mayoogh-flexli/Meesho-Put-To-Light/PTL-RAIL/PTL-RAIL.kicad_pcb

## KiCad design PTL-RAIL/PTL-RAIL.kicad_pcb (2026-10-18)

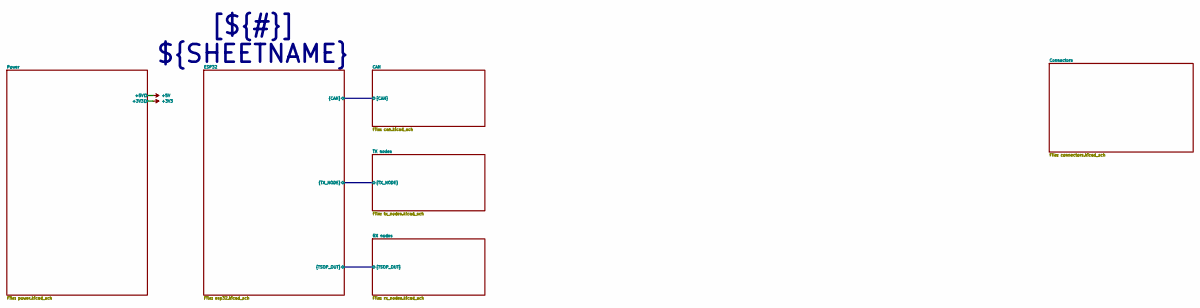
[picture p6: schematic PTL-RAIL.kicad_sch]

Notes on the sheet:
[${#}] ${SHEETNAME}

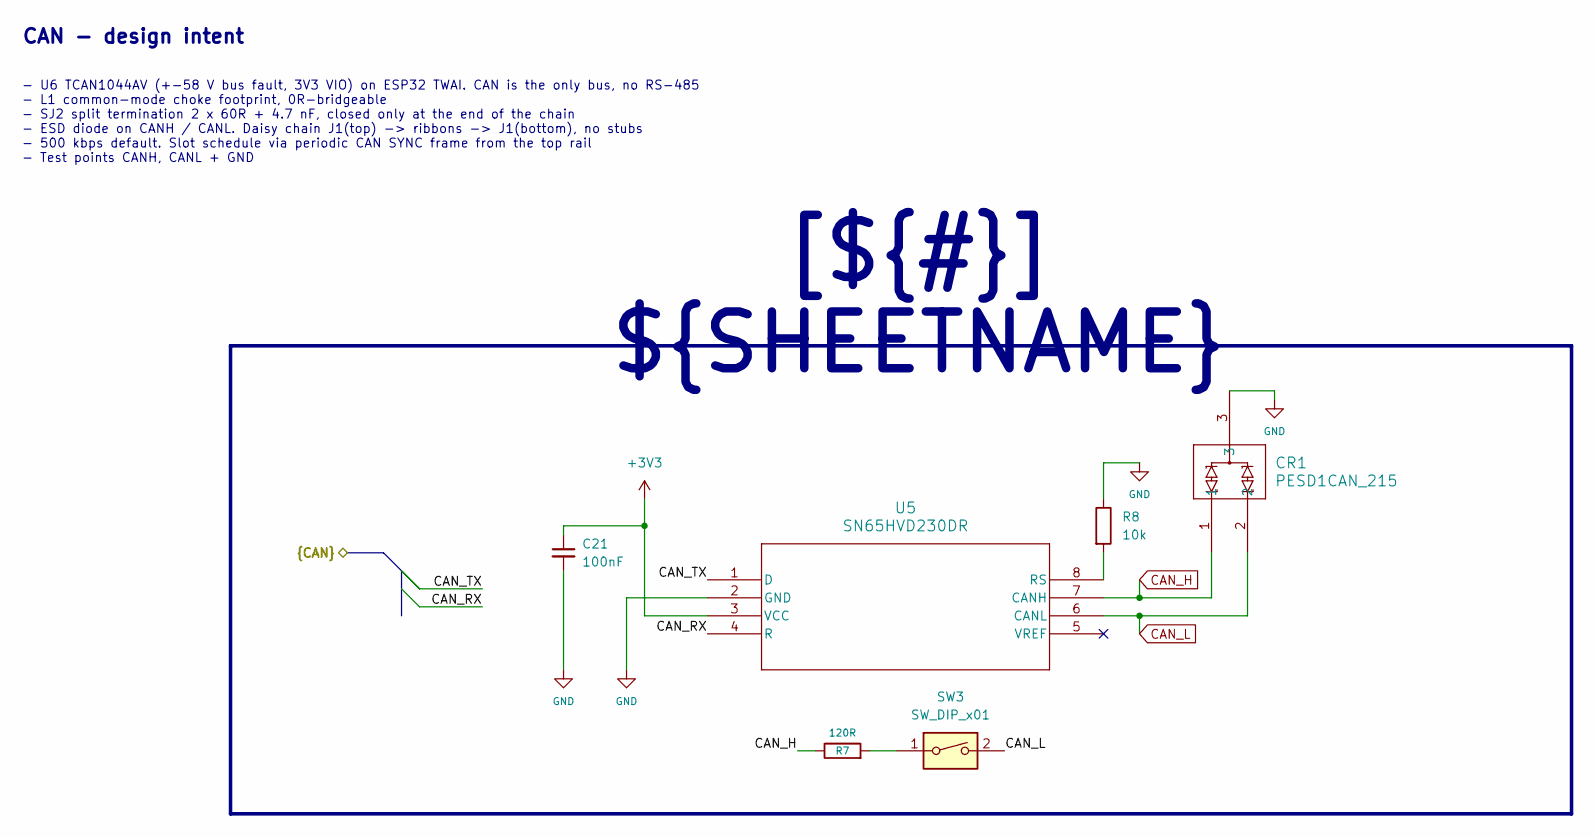
[picture p7: schematic can.kicad_sch, PTL-RAIL CAN]

Parts:
C21: 100nF; C_0805_2012Metric
CR1: PESD1CAN_215; SOT-23
R7: 120R; R_0805_2012Metric
R8: 10k; R_0805_2012Metric
SW3: SW_DIP_x01; SW_DIP_SPSTx01_Slide_9.78x4.72mm_W7.62mm_P2.54mm
U5: SN65HVD230DR; SOIC-8_3.9x4.9mm_P1.27mm

Connections:
+3V3: C21.1, U5.3 (VCC); also elsewhere on the board
/CAN/CAN_RX: U5.4 (R); also elsewhere on the board
/CAN/CAN_TX: U5.1 (D); also elsewhere on the board
CAN_H: CR1.1, R7.1, U5.7 (CANH); also elsewhere on the board
CAN_L: CR1.2, SW3.2, U5.6 (CANL); also elsewhere on the board
GND: C21.2, CR1.3, R8.1, U5.2 (GND); also elsewhere on the board
unnamed: R7.2, SW3.1
unnamed: R8.2, U5.8 (RS)

Notes on the sheet:
CAN - design intent
- U6 TCAN1044AV (+-58 V bus fault, 3V3 VIO) on ESP32 TWAI. CAN is the only bus, no RS-485 - L1 common-mode choke footprint, 0R-bridgeable - SJ2 split termination 2 x 60R + 4.7 nF, closed only at the end of the chain - ESD diode on CANH / CANL. Daisy chain J1(top) -> ribbons -> J1(bottom), no stubs 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
[${#}] ${SHEETNAME}

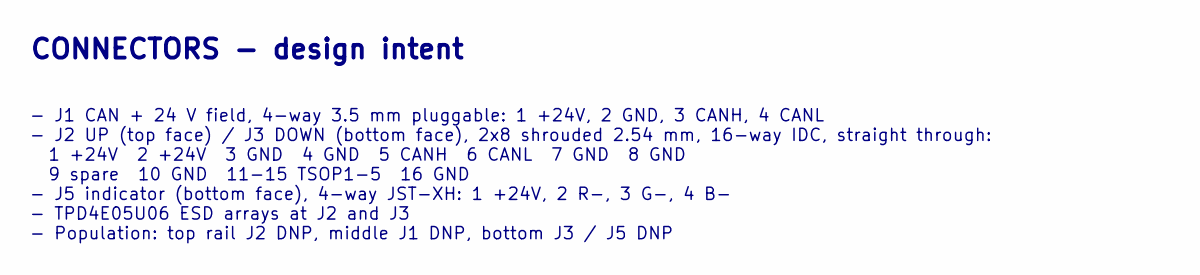
[picture p8: schematic connectors.kicad_sch, PTL-RAIL Connectors]

Notes on the sheet:
CONNECTORS - design intent
- J1 CAN + 24 V field, 4-way 3.5 mm pluggable: 1 +24V, 2 GND, 3 CANH, 4 CANL - J2 UP (top face) / J3 DOWN (bottom face), 2x8 shrouded 2.54 mm, 16-way IDC, straight through: 1 +24V 2 +24V 3 GND 4 GND 5 CANH 6 CANL 7 GND 8 GND 9 spare 10 GND 11-15 TSOP1-5 16 GND - J5 indicator (bottom face), 4-way JS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

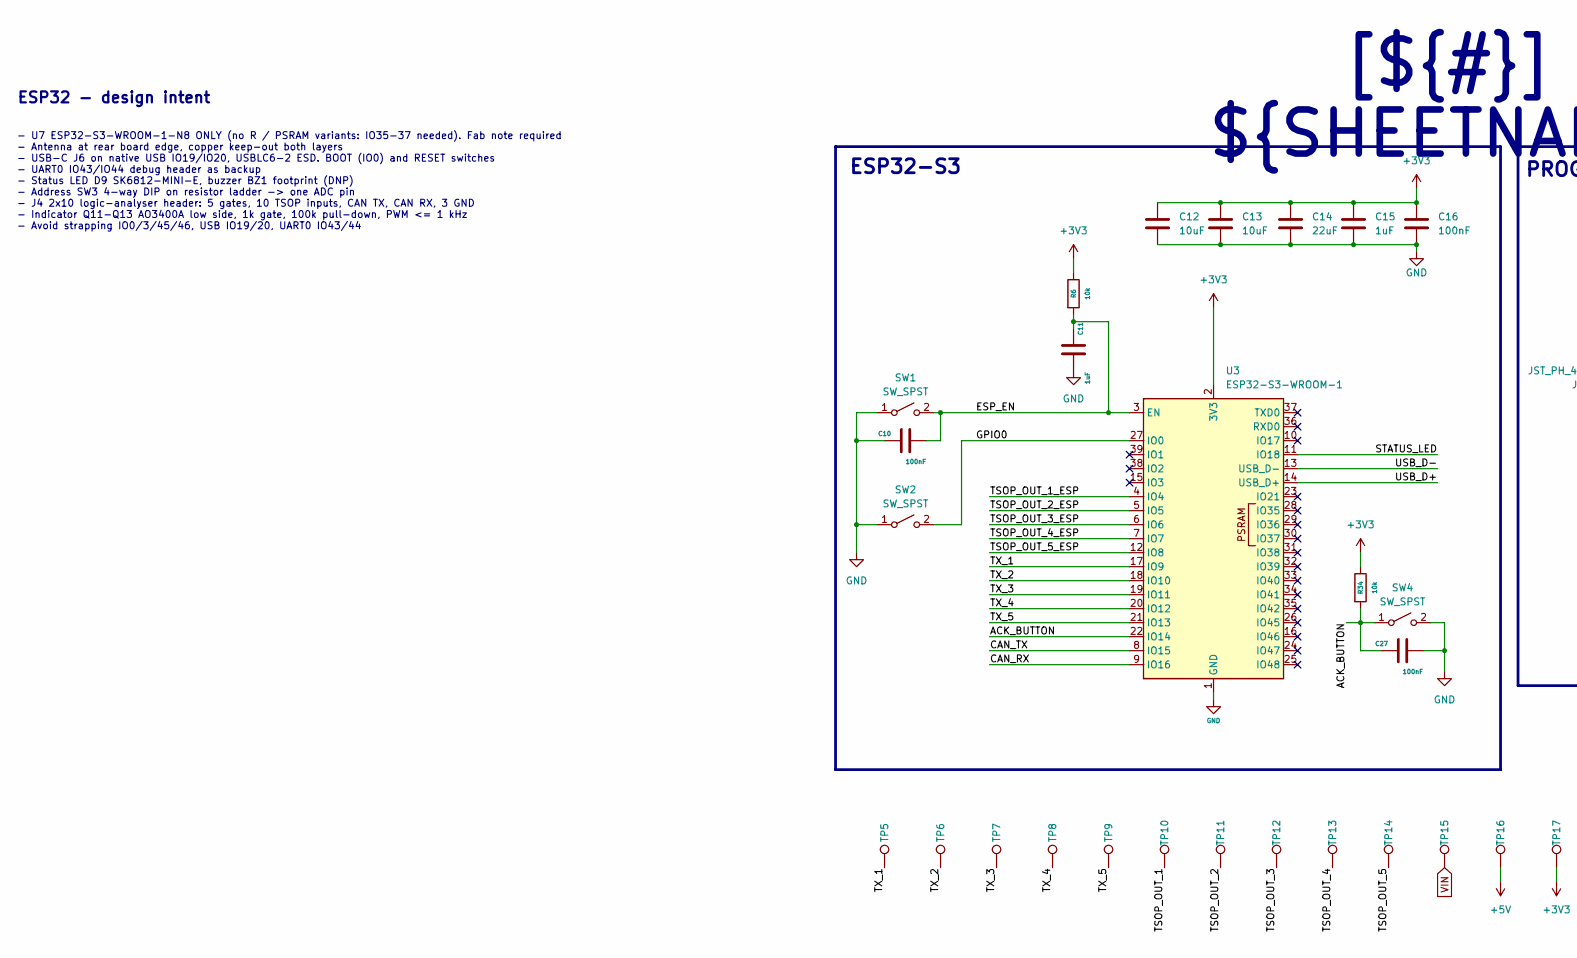
[picture p9: schematic esp32.kicad_sch, PTL-RAIL ESP32, part in row 1, column 1]

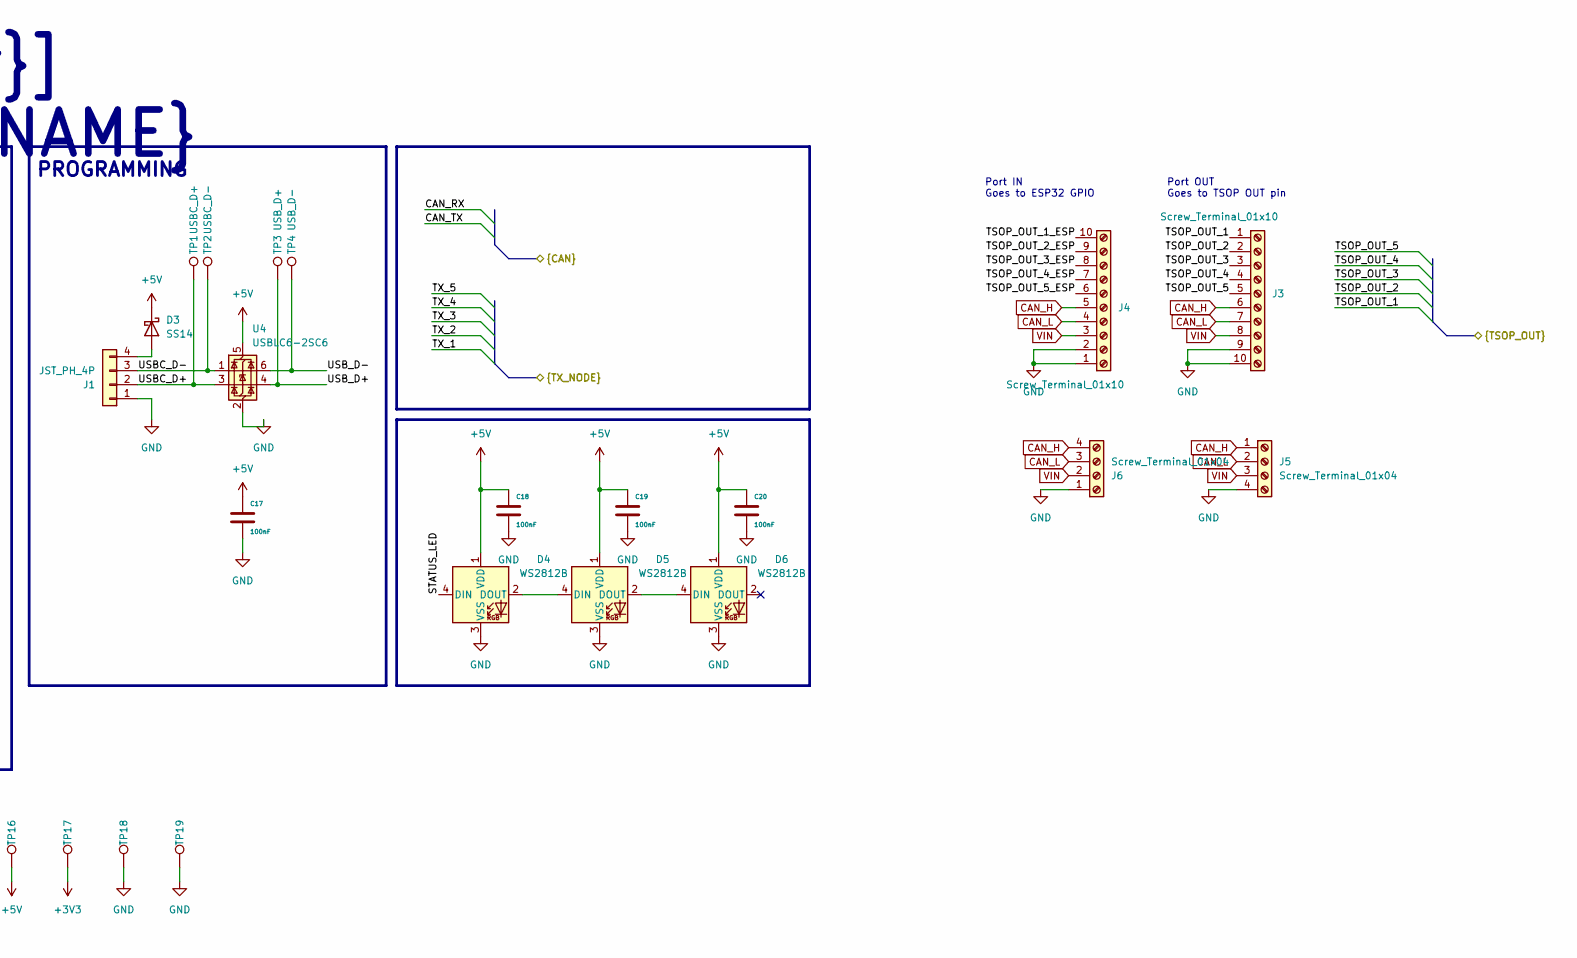
[picture p10: schematic esp32.kicad_sch, PTL-RAIL ESP32, part in row 1, column 2]

Parts:
C10, C16, C17, C18, C19, C20, C27: 100nF; C_0805_2012Metric
C11, C15: 1uF; C_0805_2012Metric
C12, C13: 10uF; C_0805_2012Metric
C14: 22uF; C_0805_2012Metric
D3: SS14; D_SMA
D4, D5, D6: WS2812B; LED_WS2812B_PLCC4_5.0x5.0mm_P3.2mm
J1: JST_PH_4P; JST_PH_B4B-PH-K_1x04_P2.00mm_Vertical
J3, J4: Screw_Terminal_01x10; TerminalBlock_4Ucon_1x10_P3.50mm_Horizontal
J5, J6: Screw_Terminal_01x04; TerminalBlock_4Ucon_1x04_P3.50mm_Horizontal
R6, R34: 10k; R_0805_2012Metric
SW1, SW2, SW4: SW_SPST; SW_SPST_PTS645Sx43SMTR92
TP1: USBC_D+; TestPoint_Pad_D1.5mm
TP2: USBC_D-; TestPoint_Pad_D1.5mm
TP3: USB_D+; TestPoint_Pad_D1.5mm
TP4: USB_D-; TestPoint_Pad_D1.5mm
TP5: TX_1; TestPoint_Loop_D1.80mm_Drill1.0mm_Beaded
TP6: TX_2; TestPoint_Loop_D1.80mm_Drill1.0mm_Beaded
TP7: TX_3; TestPoint_Loop_D1.80mm_Drill1.0mm_Beaded
TP8: TX_4; TestPoint_Loop_D1.80mm_Drill1.0mm_Beaded
TP9: TX_5; TestPoint_Loop_D1.80mm_Drill1.0mm_Beaded
TP10: TSOP_OUT_1; TestPoint_Loop_D1.80mm_Drill1.0mm_Beaded
TP11: TSOP_OUT_2; TestPoint_Loop_D1.80mm_Drill1.0mm_Beaded
TP12: TSOP_OUT_3; TestPoint_Loop_D1.80mm_Drill1.0mm_Beaded
TP13: TSOP_OUT_4; TestPoint_Loop_D1.80mm_Drill1.0mm_Beaded
TP14: TSOP_OUT_5; TestPoint_Loop_D1.80mm_Drill1.0mm_Beaded
TP15: VIN; TestPoint_Loop_D1.80mm_Drill1.0mm_Beaded
TP16: +5V; TestPoint_Loop_D1.80mm_Drill1.0mm_Beaded
TP17: +3V3; TestPoint_Loop_D1.80mm_Drill1.0mm_Beaded
TP18, TP19: GND; TestPoint_Loop_D1.80mm_Drill1.0mm_Beaded
U3: ESP32-S3-WROOM-1
U4: USBLC6-2SC6; SOT-23-6

Connections:
+3V3: C12.1, C13.1, C14.1, C15.1, C16.1, R6.1, R34.1, TP17.1 (1_1), U3.2 (3V3); also elsewhere on the board
+5V: C17.1, C18.1, C19.1, C20.1, D3.1 (K), D4.1 (VDD), D5.1 (VDD), D6.1 (VDD), TP16.1 (1_1), U4.5 (VBUS); also elsewhere on the board
/CAN/CAN_RX: U3.9 (IO16); also elsewhere on the board
/CAN/CAN_TX: U3.8 (IO15); also elsewhere on the board
/ESP32/ACK_BUTTON: C27.1, R34.2, SW4.1 (A), U3.22 (IO14)
/ESP32/ESP_EN: C10.2, C11.1, R6.2, SW1.2 (B), U3.3 (EN)
/ESP32/GPIO0: SW2.2 (B), U3.27 (IO0)
/ESP32/STATUS_LED: D4.4 (DIN), U3.11 (IO18)
/ESP32/TSOP_OUT_1: J3.1, TP10.1 (1_1); also elsewhere on the board
/ESP32/TSOP_OUT_1_ESP: J4.10, U3.4 (IO4)
/ESP32/TSOP_OUT_2: J3.2, TP11.1 (1_1); also elsewhere on the board
/ESP32/TSOP_OUT_2_ESP: J4.9, U3.5 (IO5)
/ESP32/TSOP_OUT_3: J3.3, TP12.1 (1_1); also elsewhere on the board
/ESP32/TSOP_OUT_3_ESP: J4.8, U3.6 (IO6)
/ESP32/TSOP_OUT_4: J3.4, TP13.1 (1_1); also elsewhere on the board
/ESP32/TSOP_OUT_4_ESP: J4.7, U3.7 (IO7)
/ESP32/TSOP_OUT_5: J3.5, TP14.1 (1_1); also elsewhere on the board
/ESP32/TSOP_OUT_5_ESP: J4.6, U3.12 (IO8)
/ESP32/TX_1: TP5.1 (1_1), U3.17 (IO9); also elsewhere on the board
/ESP32/TX_2: TP6.1 (1_1), U3.18 (IO10); also elsewhere on the board
/ESP32/TX_3: TP7.1 (1_1), U3.19 (IO11); also elsewhere on the board
/ESP32/TX_4: TP8.1 (1_1), U3.20 (IO12); also elsewhere on the board
/ESP32/TX_5: TP9.1 (1_1), U3.21 (IO13); also elsewhere on the board
/ESP32/USBC_D+: J1.2, TP1.1 (1_1), U4.3 (I/O2)
/ESP32/USBC_D-: J1.3, TP2.1 (1_1), U4.1 (I/O1)
/ESP32/USB_D+: TP3.1 (1_1), U3.14 (USB_D+), U4.4 (I/O2)
/ESP32/USB_D-: TP4.1 (1_1), U3.13 (USB_D-), U4.6 (I/O1)
CAN_H: J3.6, J4.5, J5.1, J6.4; also elsewhere on the board
CAN_L: J3.7, J4.4, J5.2, J6.3; also elsewhere on the board
GND: C10.1, C11.2, C12.2, C13.2, C14.2, C15.2, C16.2, C17.2, C18.2, C19.2, C20.2, C27.2, D4.3 (VSS), D5.3 (VSS), D6.3 (VSS), J1.1, J3.9, J3.10, J4.1, J4.2, J5.4, J6.1, SW1.1 (A), SW2.1 (A), SW4.2 (B), TP18.1 (1_1), TP19.1 (1_1), U3.1 (GND), U3.40 (GND), U3.41 (GND), U4.2 (GND); also elsewhere on the board
unnamed: D3.2 (A), J1.4
unnamed: D4.2 (DOUT), D5.4 (DIN)
unnamed: D5.2 (DOUT), D6.4 (DIN)
VIN: J3.8, J4.3, J5.3, J6.2, TP15.1 (1_1); also elsewhere on the board

Notes on the sheet:
PROGRAMMING
- U7 ESP32-S3-WROOM-1-N8 ONLY (no R / PSRAM variants: IO35-37 needed). Fab note required - Antenna at rear board edge, copper keep-out both layers - USB-C J6 on native USB IO19/IO20, USBLC6-2 ESD. BOOT (IO0) and RESET switches - UART0 IO43/IO44 debug header as backup - Status LED D9 SK6812-MINI-E, 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
Port OUT Goes to TSOP OUT pin
ESP32-S3
ESP32 - design intent
Port IN Goes to ESP32 GPIO
[${#}] ${SHEETNAME}

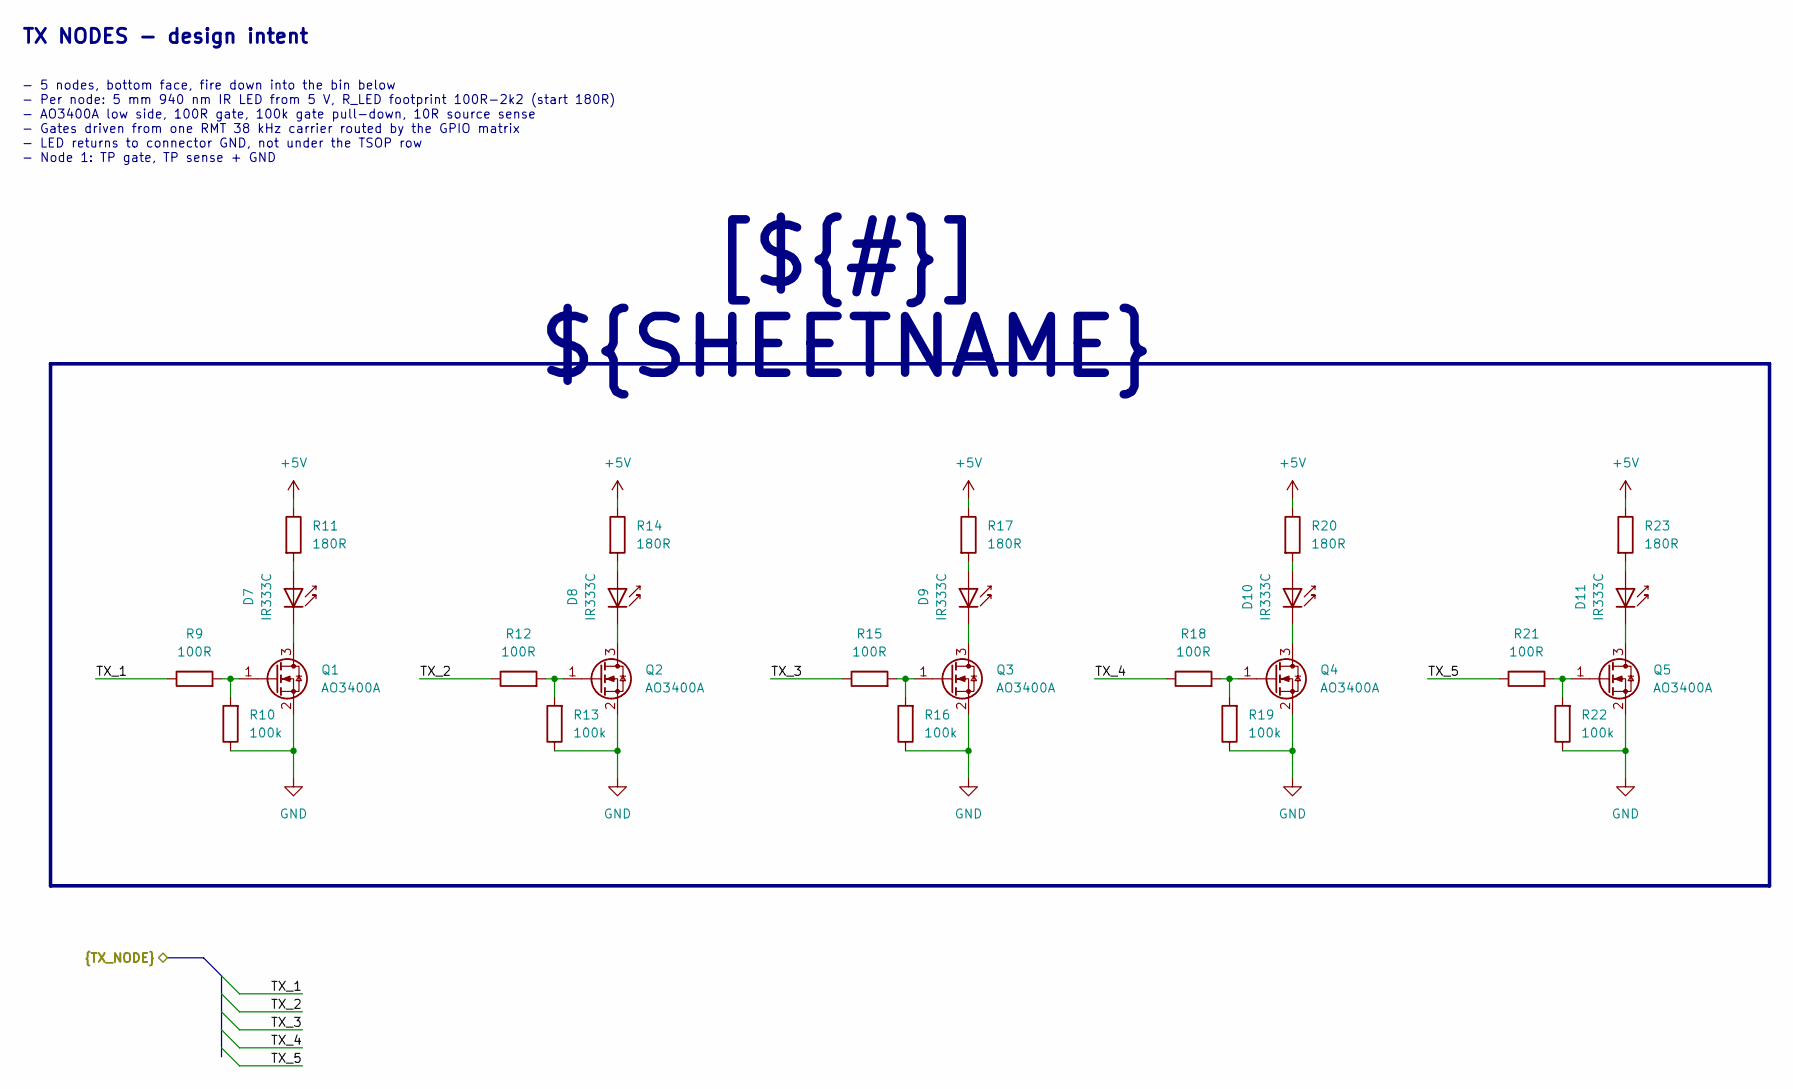
[picture p11: schematic tx_nodes.kicad_sch, PTL-RAIL TX nodes]

Parts:
D7, D8, D9, D10, D11: IR333C; LED_D5.0mm_Horizontal_O1.27mm_Z3.0mm_IRGrey
Q1, Q2, Q3, Q4, Q5: AO3400A; SOT-23
R9, R12, R15, R18, R21: 100R; R_0805_2012Metric
R10, R13, R16, R19, R22: 100k; R_0805_2012Metric
R11, R14, R17, R20, R23: 180R; R_0805_2012Metric

Connections:
+5V: R11.1, R14.1, R17.1, R20.1, R23.1; also elsewhere on the board
/ESP32/TX_1: R9.1; also elsewhere on the board
/ESP32/TX_2: R12.1; also elsewhere on the board
/ESP32/TX_3: R15.1; also elsewhere on the board
/ESP32/TX_4: R18.1; also elsewhere on the board
/ESP32/TX_5: R21.1; also elsewhere on the board
GND: Q1.2 (S), Q2.2 (S), Q3.2 (S), Q4.2 (S), Q5.2 (S), R10.1, R13.1, R16.1, R19.1, R22.1; also elsewhere on the board
unnamed: D7.2 (A), R11.2
unnamed: D7.1 (K), Q1.3 (D)
unnamed: D8.2 (A), R14.2
unnamed: D8.1 (K), Q2.3 (D)
unnamed: D9.2 (A), R17.2
unnamed: D9.1 (K), Q3.3 (D)
unnamed: D10.2 (A), R20.2
unnamed: D10.1 (K), Q4.3 (D)
unnamed: D11.2 (A), R23.2
unnamed: D11.1 (K), Q5.3 (D)
unnamed: Q1.1 (G), R9.2, R10.2
unnamed: Q2.1 (G), R12.2, R13.2
unnamed: Q3.1 (G), R15.2, R16.2
unnamed: Q4.1 (G), R18.2, R19.2
unnamed: Q5.1 (G), R21.2, R22.2

Notes on the sheet:
- 5 nodes, bottom face, fire down into the bin below - Per node: 5 mm 940 nm IR LED from 5 V, R_LED footprint 100R-2k2 (start 180R) - AO3400A low side, 100R gate, 100k gate pull-down, 10R source sense - Gates driven from one RMT 38 kHz carrier routed by the GPIO matrix - LED returns to connector GN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
TX NODES - design intent
[${#}] ${SHEETNAME}

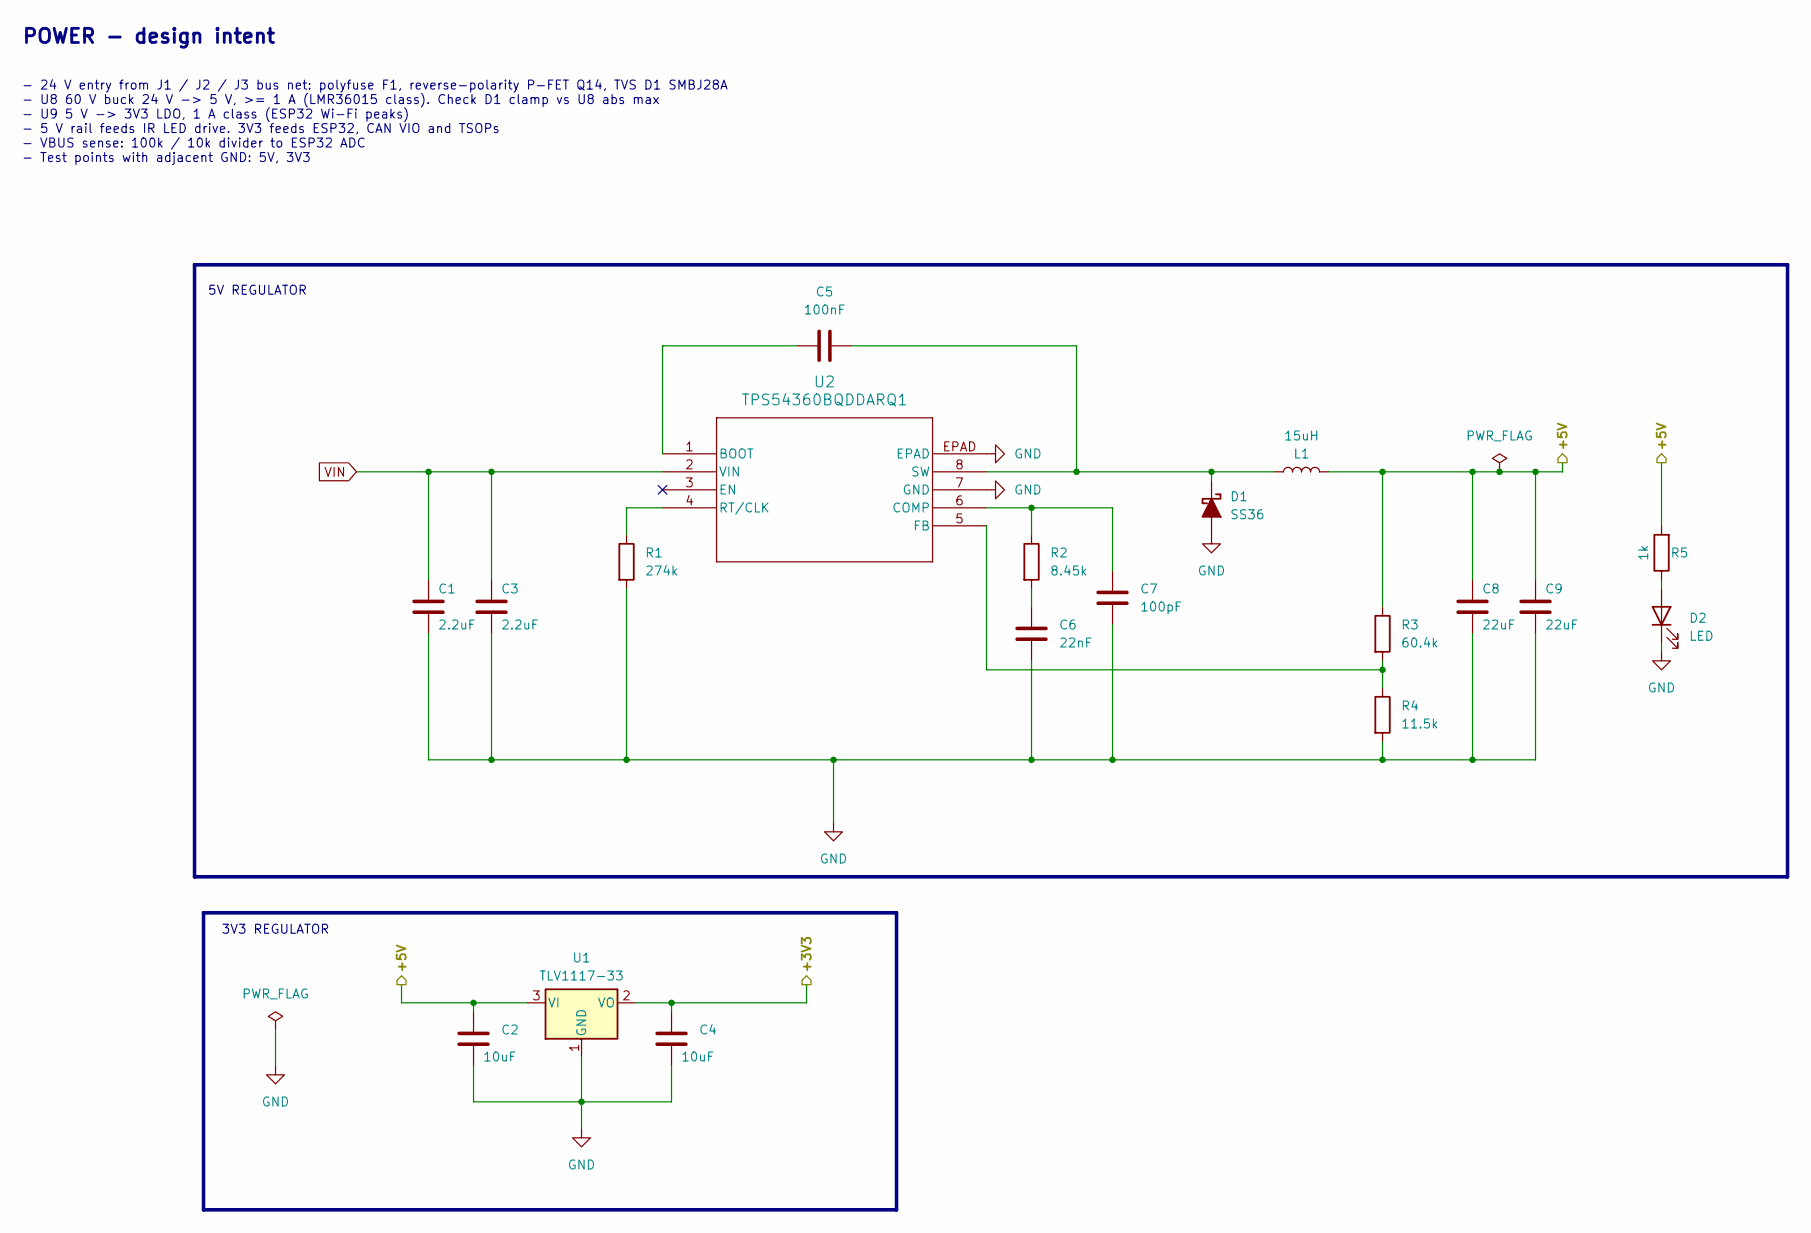
[picture p12: schematic power.kicad_sch, PTL-RAIL Power]

Parts:
C1, C3: 2.2uF; C_1210_3225Metric
C2, C4: 10uF; C_0805_2012Metric
C5: 100nF; C_0805_2012Metric
C6: 22nF; C_0805_2012Metric
C7: 100pF; C_0805_2012Metric
C8, C9: 22uF; C_1210_3225Metric
D1: SS36; D_SMC
D2: LED; LED_0805_2012Metric
L1: 15uH; L_APV_ANR8040
R1: 274k; R_0805_2012Metric
R2: 8.45k; R_0805_2012Metric
R3: 60.4k; R_0805_2012Metric
R4: 11.5k; R_0805_2012Metric
R5: 1k; R_0805_2012Metric
U1: TLV1117-33; SOT-223-3_TabPin2
U2: TPS54360BQDDARQ1

Connections:
+3V3: C4.1, U1.2 (VO); also elsewhere on the board
+5V: C2.1, C8.1, C9.1, L1.2, R3.1, R5.2, U1.3 (VI); also elsewhere on the board
GND: C1.2, C2.2, C3.2, C4.2, C6.2, C7.2, C8.2, C9.2, D1.2 (A), D2.1 (K), R1.2, R4.2, U1.1 (GND), U2.7 (GND), U2.EPAD; also elsewhere on the board
unnamed: C6.1, R2.2
unnamed: C5.2, D1.1 (K), L1.1, U2.8 (SW)
unnamed: D2.2 (A), R5.1
unnamed: C5.1, U2.1 (BOOT)
unnamed: C7.1, R2.1, U2.6 (COMP)
unnamed: R3.2, R4.1, U2.5 (FB)
unnamed: R1.1, U2.4 (RT/CLK)
VIN: C1.1, C3.1, U2.2 (VIN); also elsewhere on the board

Notes on the sheet:
POWER - design intent
3V3 REGULATOR
- 24 V entry from J1 / J2 / J3 bus net: polyfuse F1, reverse-polarity P-FET Q14, TVS D1 SMBJ28A - U8 60 V buck 24 V -> 5 V, >= 1 A (LMR36015 class). Check D1 clamp vs U8 abs max - U9 5 V -> 3V3 LDO, 1 A class (ESP32 Wi-Fi peaks) - 5 V rail feeds IR LED drive. 3V3 feeds ESP32, CAN VIO and TSOPs - VB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
5V REGULATOR

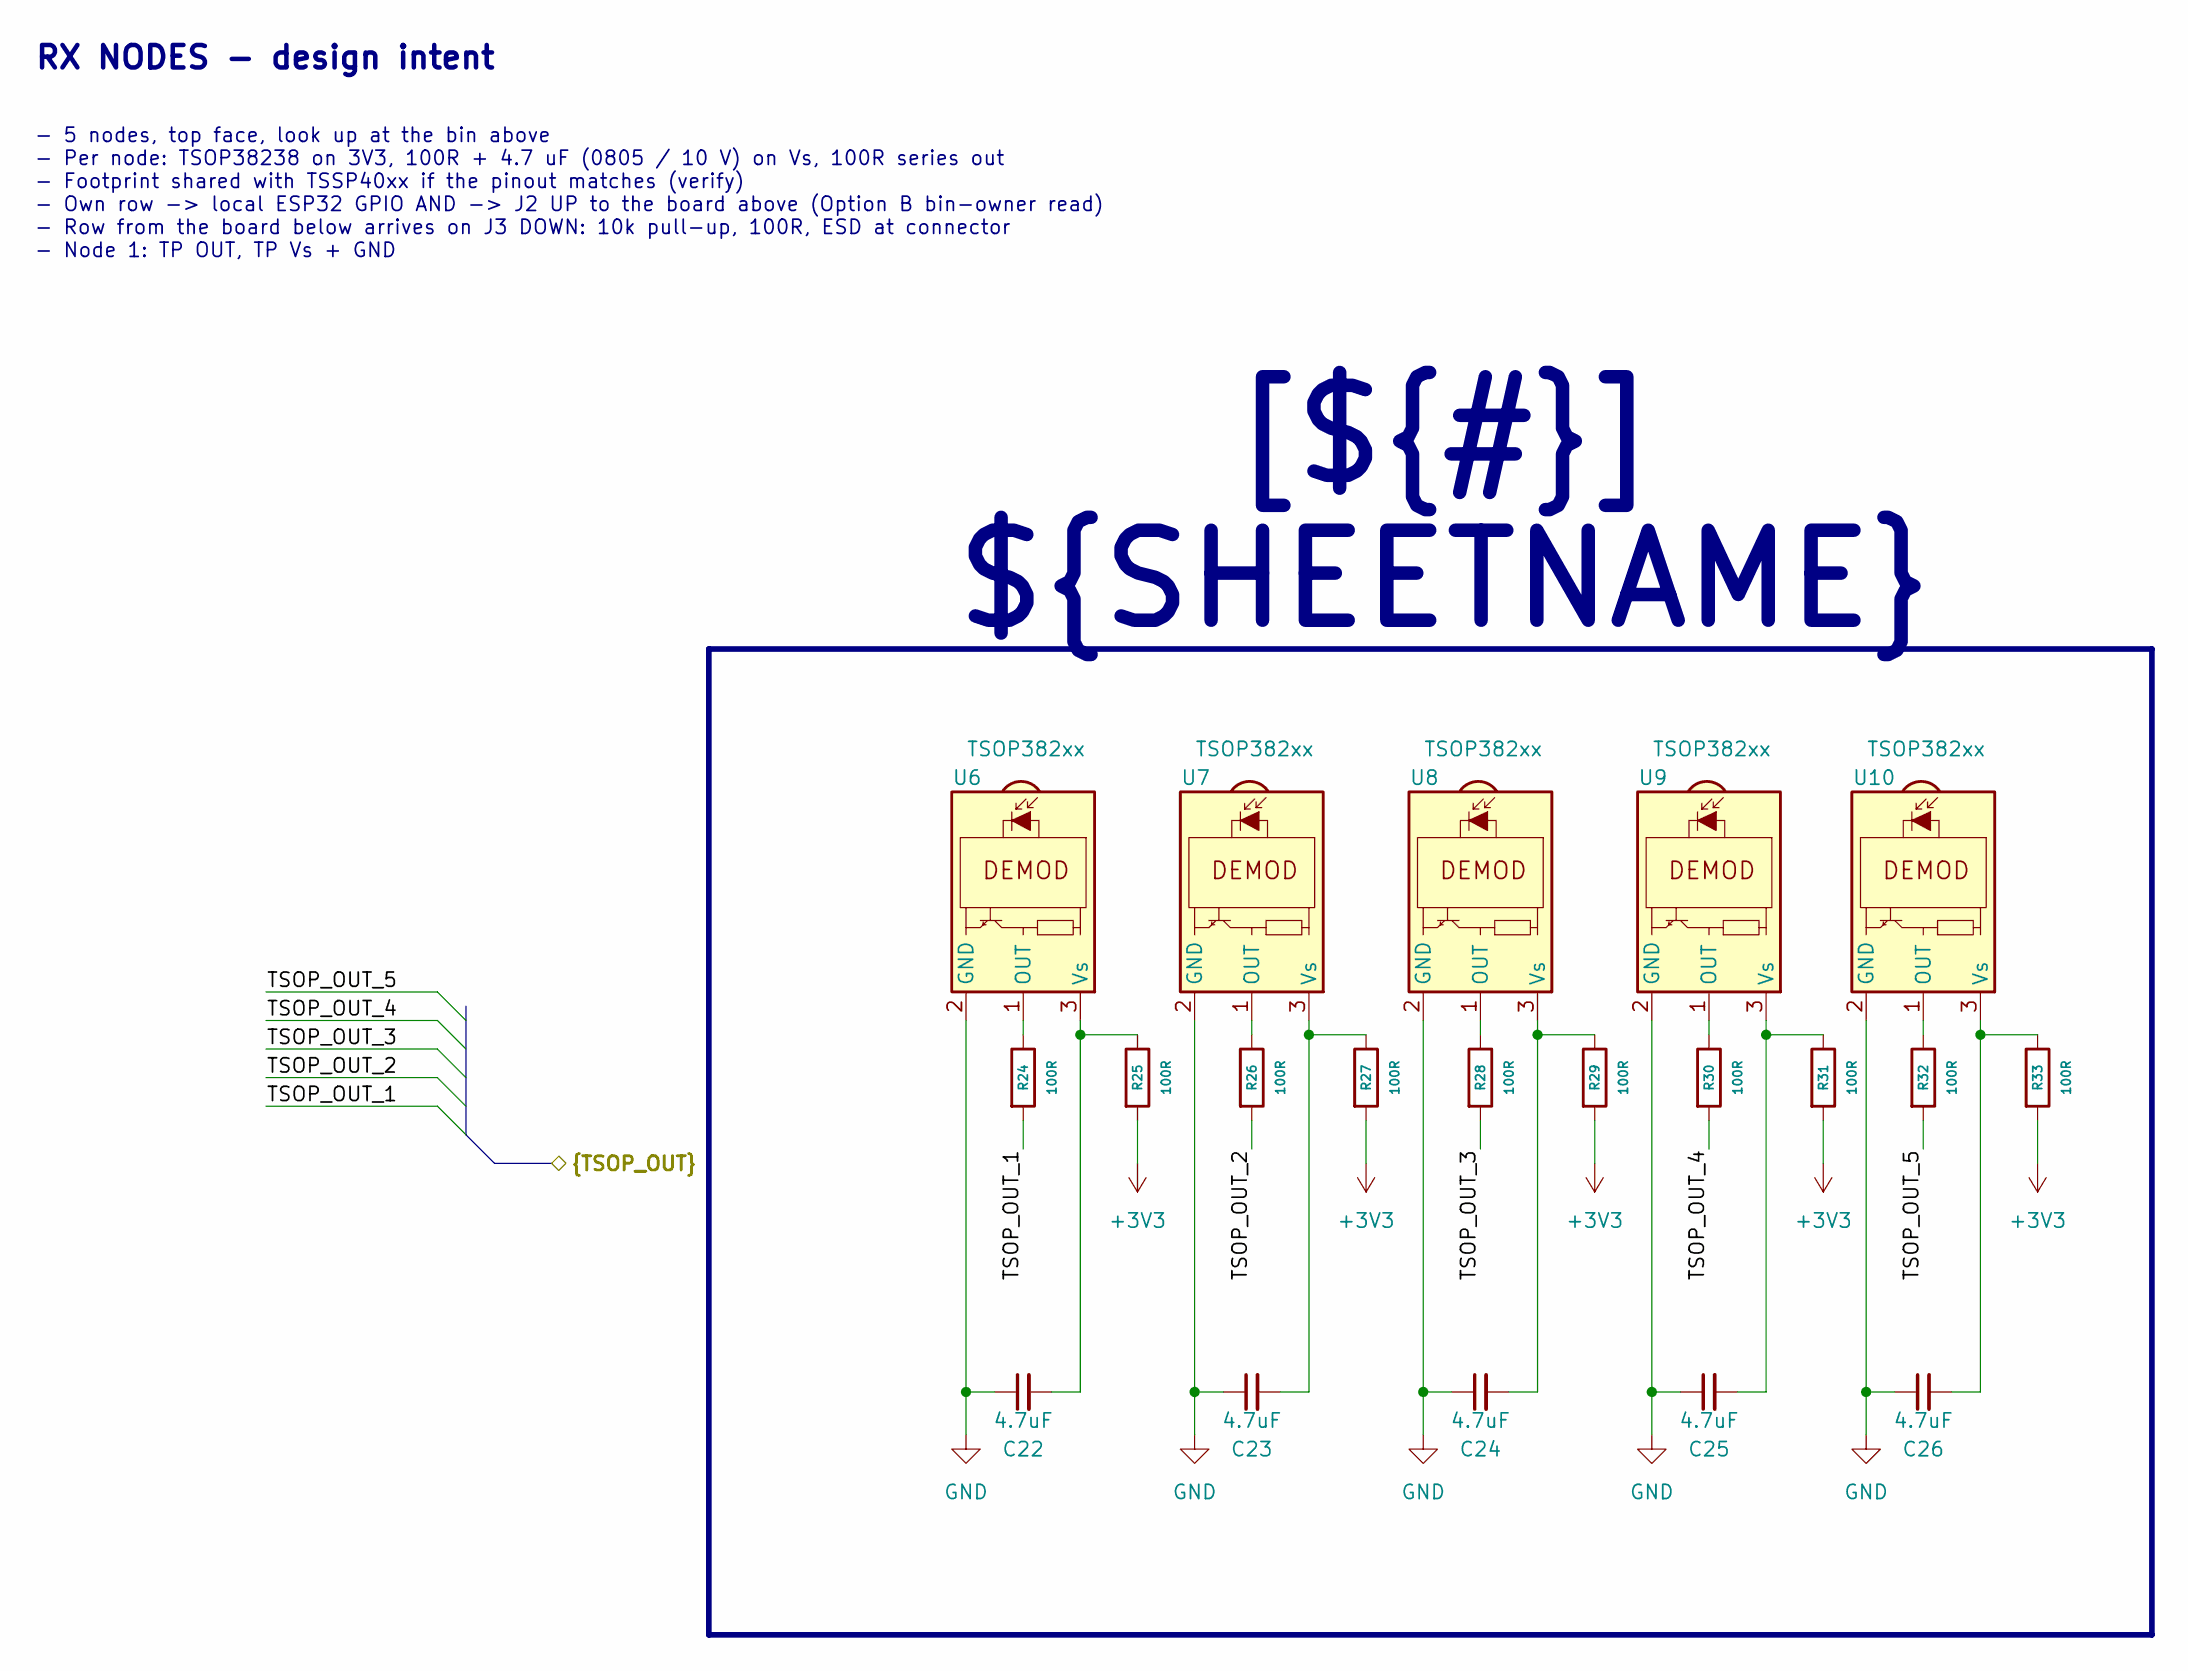
[picture p13: schematic rx_nodes.kicad_sch, PTL-RAIL RX nodes]

Parts:
C22, C23, C24, C25, C26: 4.7uF; C_0805_2012Metric
R24, R25, R26, R27, R28, R29, R30, R31, R32, R33: 100R; R_0805_2012Metric
U6, U7, U8, U9, U10: TSOP382xx; Vishay_MINICAST-3Pin

Connections:
+3V3: R25.2, R27.2, R29.2, R31.2, R33.2; also elsewhere on the board
/ESP32/TSOP_OUT_1: R24.2; also elsewhere on the board
/ESP32/TSOP_OUT_2: R26.2; also elsewhere on the board
/ESP32/TSOP_OUT_3: R28.2; also elsewhere on the board
/ESP32/TSOP_OUT_4: R30.2; also elsewhere on the board
/ESP32/TSOP_OUT_5: R32.2; also elsewhere on the board
GND: C22.1, C23.1, C24.1, C25.1, C26.1, U6.2 (GND), U7.2 (GND), U8.2 (GND), U9.2 (GND), U10.2 (GND); also elsewhere on the board
unnamed: R24.1, U6.1 (OUT)
unnamed: C22.2, R25.1, U6.3 (Vs)
unnamed: R26.1, U7.1 (OUT)
unnamed: C23.2, R27.1, U7.3 (Vs)
unnamed: R28.1, U8.1 (OUT)
unnamed: C24.2, R29.1, U8.3 (Vs)
unnamed: R30.1, U9.1 (OUT)
unnamed: C25.2, R31.1, U9.3 (Vs)
unnamed: R32.1, U10.1 (OUT)
unnamed: C26.2, R33.1, U10.3 (Vs)

Notes on the sheet:
- 5 nodes, top face, look up at the bin above - Per node: TSOP38238 on 3V3, 100R + 4.7 uF (0805 / 10 V) on Vs, 100R series out - Footprint shared with TSSP40xx if the pinout matches (verify) - Own row -> local ESP32 GPIO AND -> J2 UP to the board above (Option B bin-owner read) - Row from the board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
RX NODES - design intent
[${#}] ${SHEETNAME}

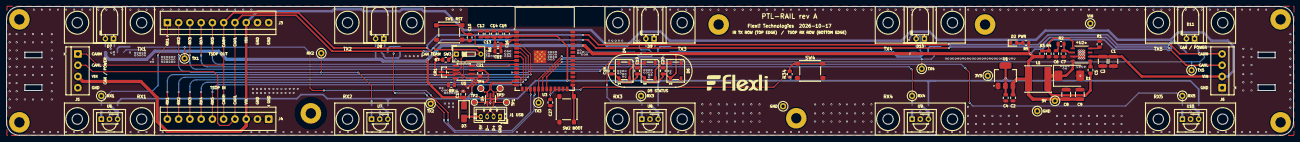
[picture p14: board PTL-RAIL.kicad_pcb from above]

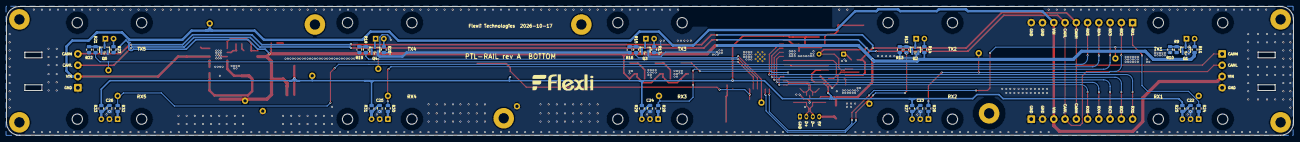
[picture p15: board PTL-RAIL.kicad_pcb from below]

Board: 2 copper layers, 400.0 x 40.0 mm, 145 parts (35 on the bottom side), 68 nets.

Other parts of the board:
H1, H2, H3, H4, H25, H26, H27, H28: MountingHole_M3; MountingHole_3.2mm_M3_Pad
H5, H6, H7, H8, H9, H10, H11, H12, H13, H14, H15, H16, H17, H18, H19, H20, H21, H22, H23, H24: MountingHole_3.2mm_M3
