mayoogh-flexli/Meesho-Put-To-Light/(commit log)

2026-10-17 PTL-RAIL rev A: KiCad project skeleton (outline, holes, node markers, sheets)
    [PTL-RAIL.kicad_pcb, PTL-RAIL.kicad_sch, can.kicad_sch, connectors.kicad_sch, esp32.kicad_sch, power.kicad_sch, rx_nodes.kicad_sch, tx_nodes.kicad_sch]
2026-10-17 PTL-RAIL: LED row on top edge, TSOP row on bottom edge, node parts aligned at 84 mm pitch; J3/J4 10-way and J5/J6 4-way screw terminals
    [PTL-RAIL.kicad_pcb, PTL-RAIL.kicad_sch, can.kicad_sch, connectors.kicad_sch, esp32.kicad_sch, power.kicad_sch, rx_nodes.kicad_sch, tx_nodes.kicad_sch]
2026-10-17 PTL-RAIL: place TX/RX node MOSFETs, resistors and caps next to their LED/TSOP
    [PTL-RAIL.kicad_pcb]
2026-10-17 PTL-RAIL: TSOP Vs decoupling caps on the Vs node; place CAN, buttons, status LED and mounting holes
    [PTL-RAIL.kicad_pcb, rx_nodes.kicad_sch]
2026-10-17 PTL-RAIL: move CAN block (U5, C21, CR1, R7, R8, SW3) to mid-board, flip node Q1-Q5/C22-C26 rotation, relocate SW1/SW2, shift C24/R28/R29
    PCB only, no tracks yet:
    - CAN transceiver U5 with C21, CR1, R7, R8 and SW3 moved from x~440 to x~550-565.
    - Q1-Q5 and C22-C26 rotation 270 -> -90; C24, R28, R29 moved down to y 698.1.
    - SW1 moved to x 618.9; SW2 moved to (649.4, 678.1) rotated 90.
    - Two unreferenced M3 mounting holes (REF**) added at (576.8, 688.2) and (592.5, 688.2); one gr_rect added.
    [PTL-RAIL.kicad_pcb]
2026-10-18 PTL-RAIL: IR shrouds, bottom-side node parts, test points, SW4 user button
    - 3D-printed shroud outlines (28 mm) with M3 mounting holes on every LED
    and TSOP node, replicated from node 2; parts cleared from shroud areas
    - TX/RX node resistors, caps and MOSFETs moved to the bottom layer and
    arranged uniformly per node
    - Filleted the TSOP output bus corners; solid zone connection on the
    starved-thermal GND pads
    - Silkscreen cleanup: uniform 0.8 mm refs, connector pin labels on both
    sides, J5/J6 mirrored labels, node TX/RX labels, title/company/date
    - Redundant GND vias and a GND via fence along the board edge
    - Mid-board mounting holes (H25-H28) and 4 mm rounded corners concentric
    wit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
    [PTL-RAIL.kicad_pcb, PTL-RAIL.kicad_sch, can.kicad_sch, esp32.kicad_sch, rx_nodes.kicad_sch]
2026-10-18 PTL-RAIL: move SW4 user button to IO14 (ACK_BUTTON), add C27 100nF debounce
    [PTL-RAIL.kicad_pcb, esp32.kicad_sch]
2026-10-18 PTL-RAIL rev A: normalize cap values, IO45 no-connect, README and docs
    - Capacitor values unified: 0.1uF -> 100nF (C10, C16-C21, C27; now one
    BOM line with C5), '4.7 µF' -> 4.7uF (C22-C26)
    - No-connect flag on U3 IO45 (ERC clean apart from 2 CAN label warnings)
    - Zones refilled
    - PTL-RAIL/README.md: board summary, pinouts, ESP32 pin map, test points,
    mounting, fab/assembly notes, production file list, rev A open issues
    - Root README points to PTL-RAIL and the release assets
    [PTL-RAIL.kicad_pcb, can.kicad_sch, esp32.kicad_sch, rx_nodes.kicad_sch]
2026-10-18 PTL-RAIL: add 3D models
    - U2 TPS54360B: assign the project STEP (lib/3d_models/TPS54360BQDDARQ1.stp)
    on the board and in the 0_IC library footprint
    - J3/J4/J5/J6 4Ucon 3.5 mm terminal blocks: KiCad 10 ships no 4Ucon
    models, use the Phoenix PT-1,5-xx-3.5-H stand-in (same pitch, pin
    positions and drill)
    [PTL-RAIL.kicad_pcb]
2026-10-18 PTL-RAIL: PCB renders (top, bottom, iso top/bottom, node 2 + ESP32)
